ThatAquarel/Cheap-FOCer-2/source/Cheap FOCer 2 60mm.kicad_pcb

## KiCad design source/Cheap FOCer 2 60mm.kicad_pcb (2024-12-27)

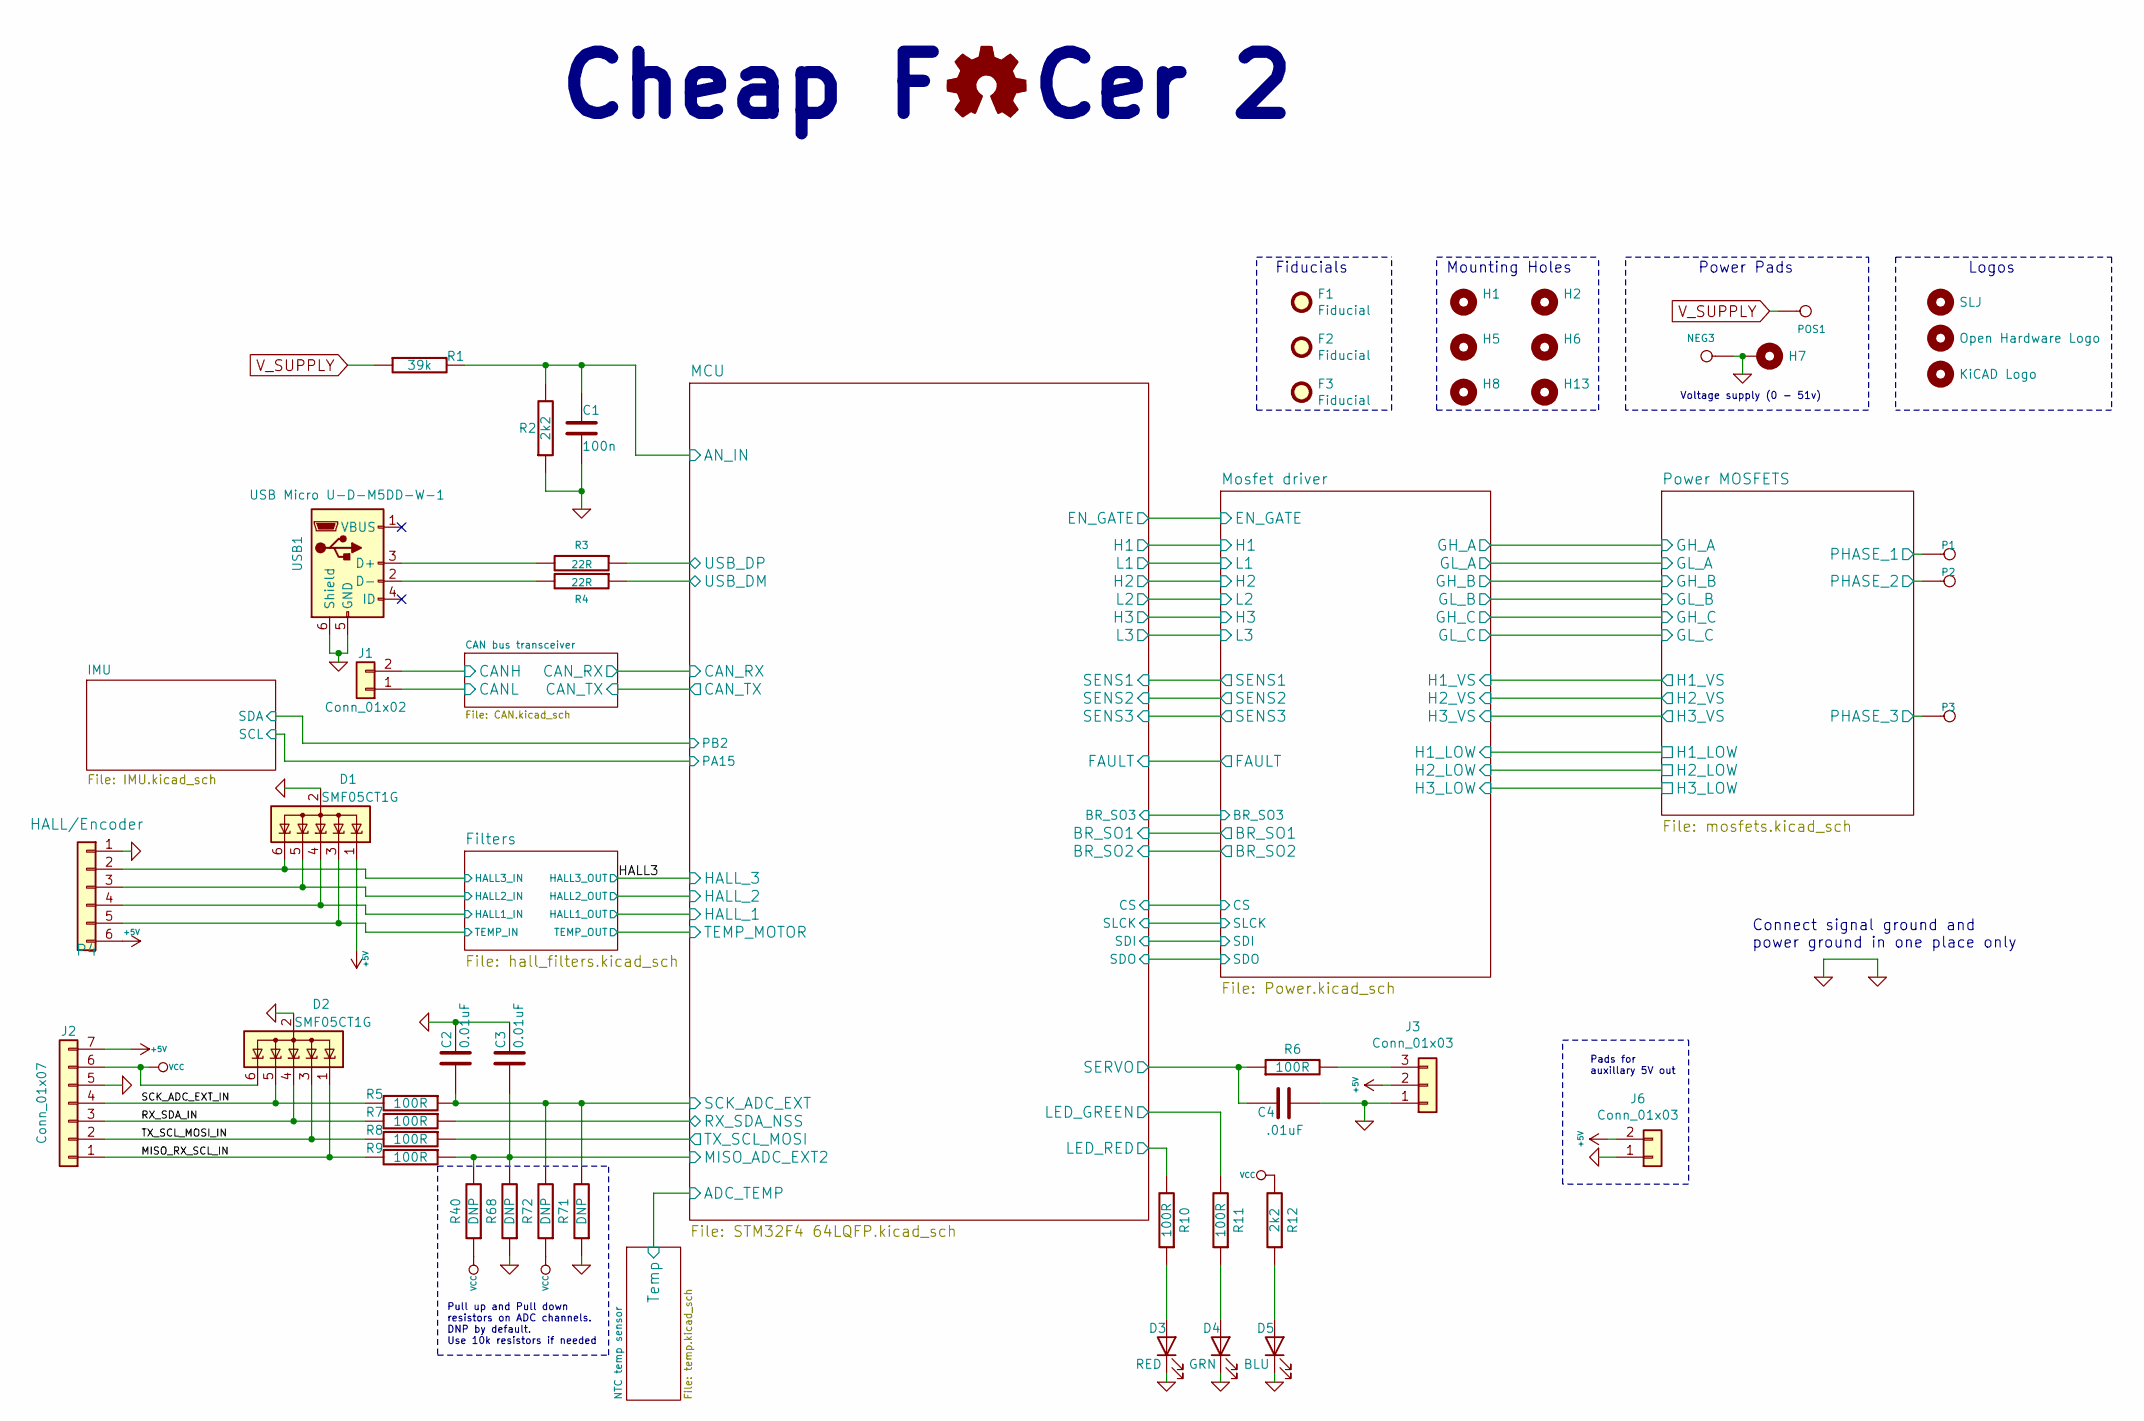
[picture p1: schematic Cheap FOCer 2 60mm.kicad_sch, Cheap FOCer 2]

Parts:
C1: 100n; C_0603_1608Metric
C2, C3: 0.01uF; C_0603_1608Metric
C4: .01uF; C_0603_1608Metric
D1, D2: SMF05CT1G; SOT-363_SC-70-6
D3: RED; LED_0603_1608Metric
D4: GRN; LED_0603_1608Metric
D5: BLU; LED_0603_1608Metric
F1, F2, F3: Fiducial; Fiducial_1mm_Dia_2mm_Outer
H1, H2, H5, H6, H7, H8, H13: MountingHole; MountingHole_3.2mm_M3_ISO14580_Pad
H3: SLJ; Sam_J
H4: Open Hardware Logo; OSHW-Logo2_9.8x8mm_SilkScreen
H9: KiCAD Logo; KiCad-Logo2_5mm_SilkScreen
J1: Conn_01x02; JST_PH_B2B-PH-K_1x02_P2.00mm_Vertical
J2: Conn_01x07; JST_PH_B7B-PH-K_1x07_P2.00mm_Vertical
J3: Conn_01x03; JST_PH_B3B-PH-K_1x03_P2.00mm_Vertical
J6: Conn_01x03; PinHeader_1x02_P2.54mm_Vertical
NEG3: MOTOR3; 1pin_4mm
P1, P2, P3: MOTOR1; 1pin_4mm
P4: HALL/Encoder; JST_PH_B6B-PH-K_1x06_P2.00mm_Vertical
POS1: POS; 1pin_4mm
R1: 39k; R_0603_1608Metric
R2, R12: 2k2; R_0603_1608Metric
R3, R4: 22R; R_0603_1608Metric
R5, R6, R7, R8, R9, R10, R11: 100R; R_0603_1608Metric
R40, R68, R71, R72: DNP; R_0603_1608Metric
USB1: USB Micro U-D-M5DD-W-1; USB_Micro-B_Wuerth_614105150721_Vertical

Connections:
+5V: D1.1 (K), J2.7, J3.2, J6.2, P4.6; also elsewhere on the board
/CAN bus transceiver/CANH: J1.2; also elsewhere on the board
/CAN bus transceiver/CANL: J1.1; also elsewhere on the board
/Filters/HALL1_IN: D1.4 (K), P4.4; also elsewhere on the board
/Filters/HALL2_IN: D1.5 (K), P4.3; also elsewhere on the board
/Filters/TEMP_IN: D1.3 (K), P4.5; also elsewhere on the board
/HALL3: D1.6 (K), P4.2; also elsewhere on the board
/MCU/AN_IN: C1.2, R1.2, R2.2; also elsewhere on the board
/MCU/LED_GREEN: R11.2; also elsewhere on the board
/MCU/LED_RED: R10.2; also elsewhere on the board
/MCU/MISO_ADC_EXT2: C3.2, R9.1, R40.2, R68.2; also elsewhere on the board
/MCU/RX_SDA_NSS: R7.1; also elsewhere on the board
/MCU/SCK_ADC_EXT: C2.2, R5.1, R71.2, R72.2; also elsewhere on the board
/MCU/SERVO: C4.2, R6.1; also elsewhere on the board
/MCU/TX_SCL_MOSI: R8.1; also elsewhere on the board
/MCU/USB_DM: R4.1; also elsewhere on the board
/MCU/USB_DP: R3.1; also elsewhere on the board
/MISO_RX_SCL_IN: D2.1 (K), J2.1, R9.2
/Mosfet driver/H1_VS: P1.1; also elsewhere on the board
/Mosfet driver/H2_VS: P2.1; also elsewhere on the board
/Mosfet driver/H3_VS: P3.1; also elsewhere on the board
/RX_SDA_IN: D2.4 (K), J2.3, R7.2
/SCK_ADC_EXT_IN: D2.5 (K), J2.4, R5.2
/TX_SCL_MOSI_IN: D2.3 (K), J2.2, R8.2
GND: C1.1, C2.1, C3.1, C4.1, D1.2 (A), D2.2 (A), D3.1 (K), D4.1 (K), D5.1 (K), H7.1, J2.5, J3.1, J6.1, NEG3.1, P4.1, R2.1, R68.1, R71.1, USB1.5 (GND), USB1.6 (Shield); also elsewhere on the board
unnamed: D3.2 (A), R10.1
unnamed: D4.2 (A), R11.1
unnamed: D5.2 (A), R12.1
unnamed: J3.3, R6.2
unnamed: R3.2, USB1.3 (D+)
unnamed: R4.2, USB1.2 (D-)
V_SUPPLY: POS1.1, R1.1; also elsewhere on the board

Notes on the sheet:
Mounting Holes
Pull up and Pull down resistors on ADC channels. DNP by default. Use 10k resistors if needed
Power Pads
Connect signal ground and power ground in one place only
Pads for auxillary 5V out
Logos
Fiducials
Voltage supply (0 - 51v)
Cheap F Cer 2

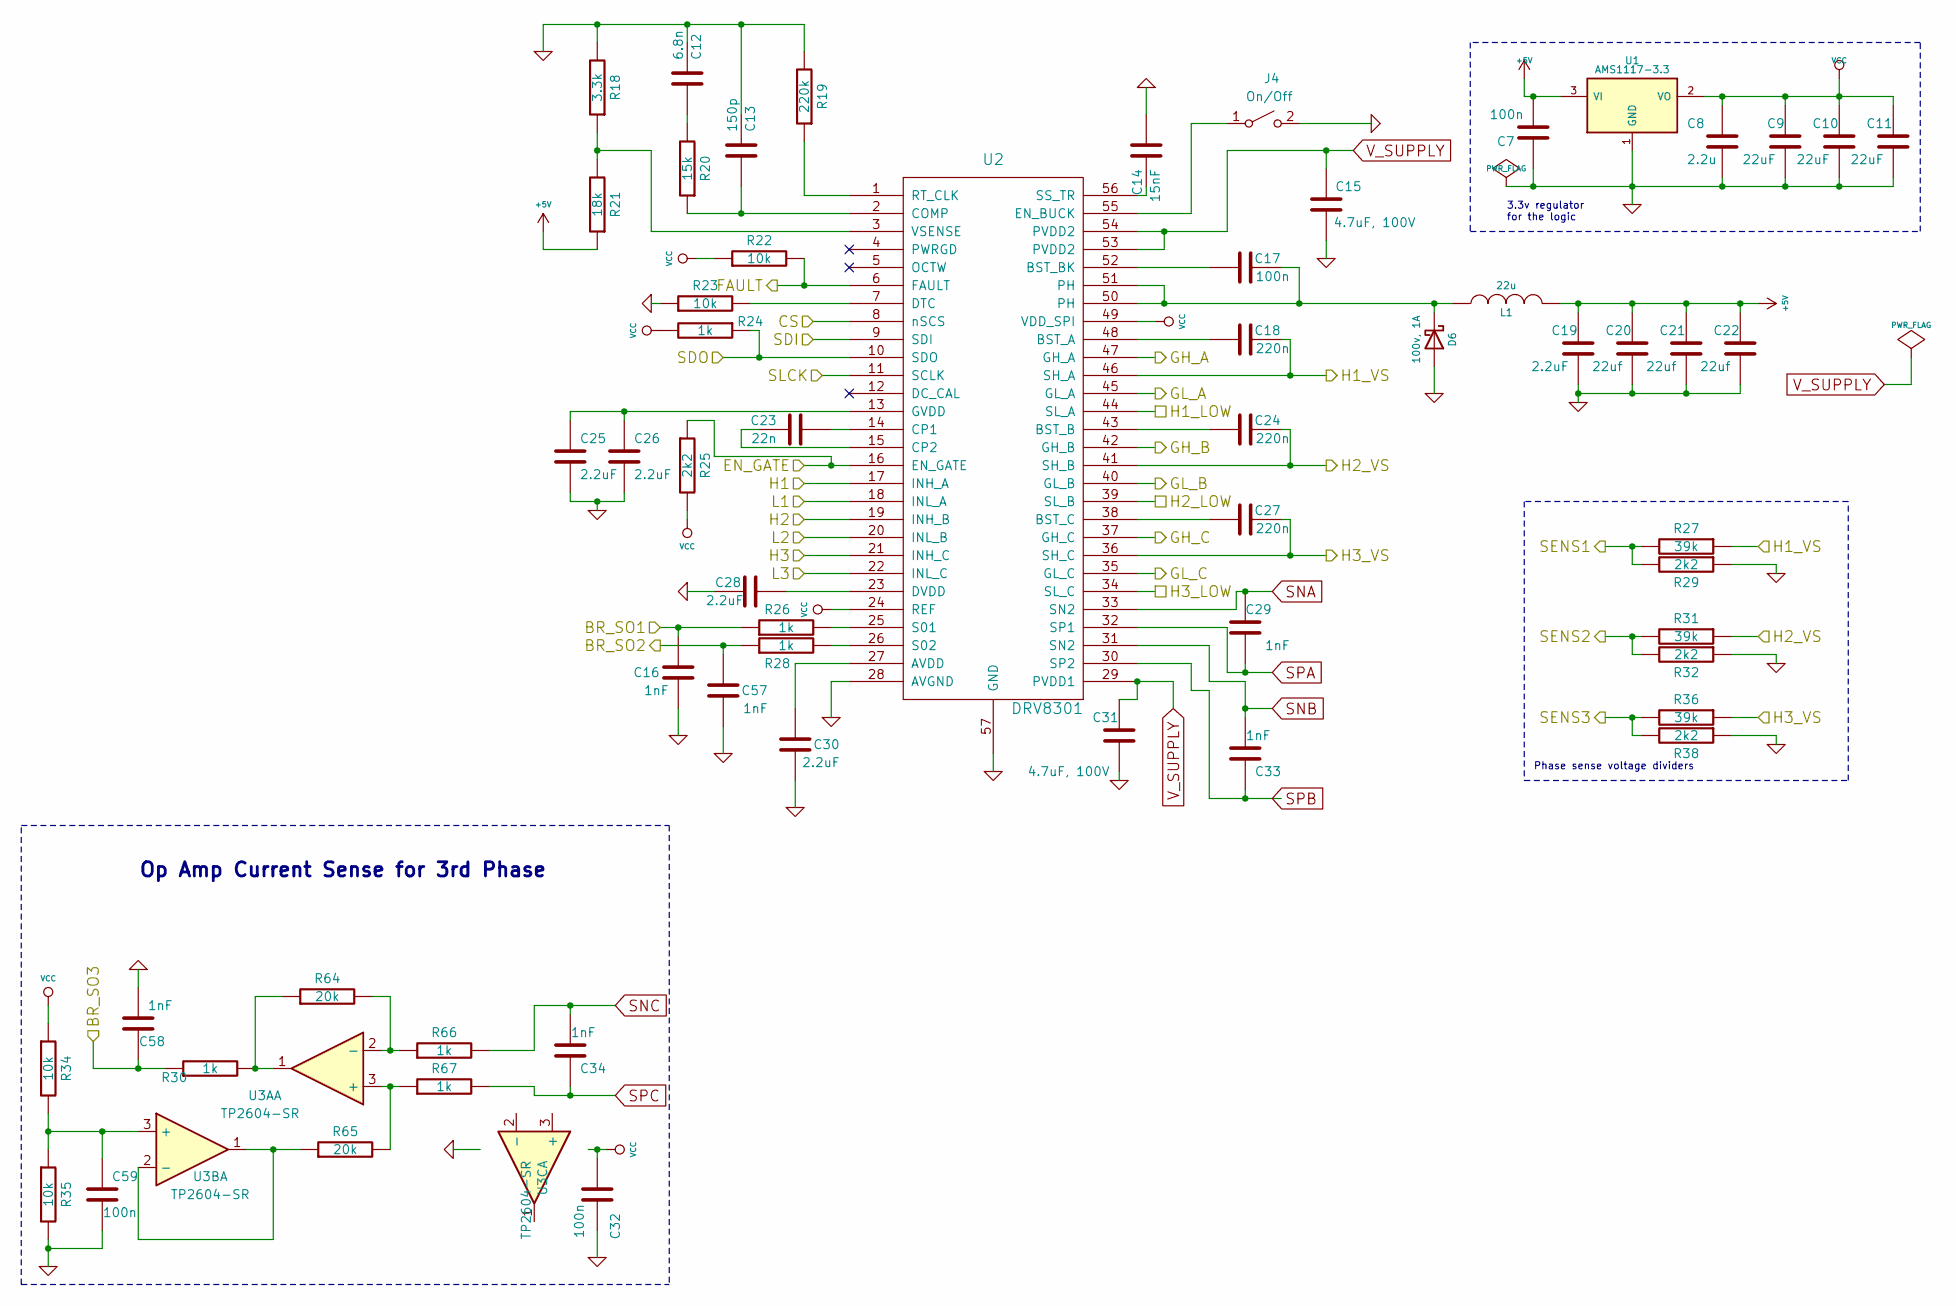
[picture p2: schematic Power.kicad_sch, Cheap FOCer 2]

Parts:
C7, C17, C32, C59: 100n; C_0603_1608Metric
C8: 2.2u; C_0603_1608Metric
C9, C10, C11: 22uF; C_0805_2012Metric
C12: 6.8n; C_0603_1608Metric
C13: 150p; C_0603_1608Metric
C14: 15nF; C_0603_1608Metric
C15, C31: 4.7uF, 100V; C_1210_3225Metric
C16, C29, C33, C34, C57, C58: 1nF; C_0603_1608Metric
C18, C24, C27: 220n; C_0603_1608Metric
C19, C25, C26, C28, C30: 2.2uF; C_0603_1608Metric
C20, C21, C22: 22uf; C_0805_2012Metric
C23: 22n; C_0603_1608Metric
D6: 100v, 1A; D_SMA
J4: On/Off; JST_PH_B2B-PH-K_1x02_P2.00mm_Vertical
L1: 22u; L_Taiyo-Yuden_NR-60xx_HandSoldering
R18: 3.3k; R_0603_1608Metric
R19: 220k; R_0603_1608Metric
R20: 15k; R_0603_1608Metric
R21: 18k; R_0603_1608Metric
R22, R23, R34, R35: 10k; R_0603_1608Metric
R24, R26, R28, R30, R66, R67: 1k; R_0603_1608Metric
R25, R29, R32, R38: 2k2; R_0603_1608Metric
R27, R31, R36: 39k; R_0603_1608Metric
R64, R65: 20k; R_0603_1608Metric
U1: AMS1117-3.3; SOT-223-3_TabPin2
U2: DRV8301; HTSSOP-56-1EP_6.1x14mm_P0.5mm_EP3.61x6.35mm
U3A, U3B, U3C: TP2604-SR; SOIC-8_3.9x4.9mm_P1.27mm

Connections:
+5V: C7.2, C19.2, C20.2, C21.2, C22.2, L1.2, R21.1, U1.3 (VI); also elsewhere on the board
/MCU/BR_SO1: C16.2, R26.1; also elsewhere on the board
/MCU/BR_SO2: C57.2, R28.1; also elsewhere on the board
/MCU/BR_SO3: C58.2, R30.1; also elsewhere on the board
/MCU/CS: U2.8 (nSCS); also elsewhere on the board
/MCU/EN_GATE: R25.1, U2.16 (EN_GATE); also elsewhere on the board
/MCU/FAULT: R22.2, U2.6 (FAULT); also elsewhere on the board
/MCU/H1: U2.17 (INH_A); also elsewhere on the board
/MCU/H2: U2.19 (INH_B); also elsewhere on the board
/MCU/H3: U2.21 (INH_C); also elsewhere on the board
/MCU/L1: U2.18 (INL_A); also elsewhere on the board
/MCU/L2: U2.20 (INL_B); also elsewhere on the board
/MCU/L3: U2.22 (INL_C); also elsewhere on the board
/MCU/SDI: U2.9 (SDI); also elsewhere on the board
/MCU/SDO: R24.1, U2.10 (SDO); also elsewhere on the board
/MCU/SENS1: R27.2, R29.2; also elsewhere on the board
/MCU/SENS2: R31.2, R32.2; also elsewhere on the board
/MCU/SENS3: R36.2, R38.2; also elsewhere on the board
/MCU/SLCK: U2.11 (SCLK); also elsewhere on the board
/Mosfet driver/GH_A: U2.47 (GH_A); also elsewhere on the board
/Mosfet driver/GH_B: U2.42 (GH_B); also elsewhere on the board
/Mosfet driver/GH_C: U2.37 (GH_C); also elsewhere on the board
/Mosfet driver/GL_A: U2.45 (GL_A); also elsewhere on the board
/Mosfet driver/GL_B: U2.40 (GL_B); also elsewhere on the board
/Mosfet driver/H1_VS: C18.2, R27.1, U2.46 (SH_A); also elsewhere on the board
/Mosfet driver/H2_LOW: U2.39 (SL_B); also elsewhere on the board
/Mosfet driver/H2_VS: C24.2, R31.1, U2.41 (SH_B); also elsewhere on the board
/Mosfet driver/H3_LOW: U2.34 (SL_C); also elsewhere on the board
/Mosfet driver/H3_VS: C27.2, R36.1, U2.36 (SH_C); also elsewhere on the board
GND: C7.1, C8.2, C9.1, C10.1, C11.1, C12.1, C13.1, C14.2, C15.1, C16.1, C19.1, C20.1, C21.1, C22.1, C25.2, C26.2, C28.2, C30.1, C31.1, C32.1, C57.1, C58.1, C59.2, D6.2 (A), J4.2 (B), R18.2, R19.2, R23.1, R29.1, R32.1, R35.2, R38.1, U1.1 (GND), U2.28 (AVGND), U2.57 (GND); also elsewhere on the board
unnamed: C12.2, R20.2
unnamed: C13.2, R20.1, U2.2 (COMP)
unnamed: C14.1, U2.56 (SS_TR)
unnamed: C17.1, U2.52 (BST_BK)
unnamed: C17.2, D6.1 (K), L1.1, U2.50 (PH), U2.51 (PH)
unnamed: C18.1, U2.48 (BST_A)
unnamed: C23.1, U2.15 (CP2)
unnamed: C23.2, U2.14 (CP1)
unnamed: C24.1, U2.43 (BST_B)
unnamed: C25.1, C26.1, U2.13 (GVDD)
unnamed: C27.1, U2.38 (BST_C)
unnamed: C28.1, U2.23 (DVDD)
unnamed: C30.2, U2.27 (AVDD)
unnamed 75: C59.1, R34.2, R35.1, U3B.3 (+); also elsewhere on the board
unnamed: J4.1 (A), U2.55 (EN_BUCK)
unnamed: R18.1, R21.2, U2.3 (VSENSE)
unnamed: R19.1, U2.1 (RT_CLK)
unnamed: R23.2, U2.7 (DTC)
unnamed: R26.2, U2.25 (S01)
unnamed: R28.2, U2.26 (S02)
unnamed 92: R30.2, R64.1, U3A.1; also elsewhere on the board
unnamed 93: R64.2, R66.1, U3A.2 (-); also elsewhere on the board
unnamed 94: R65.1, U3B.1, U3B.2 (-); also elsewhere on the board
unnamed 95: R65.2, R67.1, U3A.3 (+); also elsewhere on the board
SNA: C29.2, U2.33 (SN2); also elsewhere on the board
SNB: C33.1, U2.31 (SN2); also elsewhere on the board
SNC: C34.1, R66.2; also elsewhere on the board
SPA: C29.1, U2.32 (SP1); also elsewhere on the board
SPB: C33.2, U2.30 (SP2); also elsewhere on the board
SPC: C34.2, R67.2; also elsewhere on the board
V_SUPPLY: C15.2, C31.2, U2.29 (PVDD1), U2.53 (PVDD2), U2.54 (PVDD2); also elsewhere on the board

Notes on the sheet:
Phase sense voltage dividers
3.3v regulator for the logic
Op Amp Current Sense for 3rd Phase

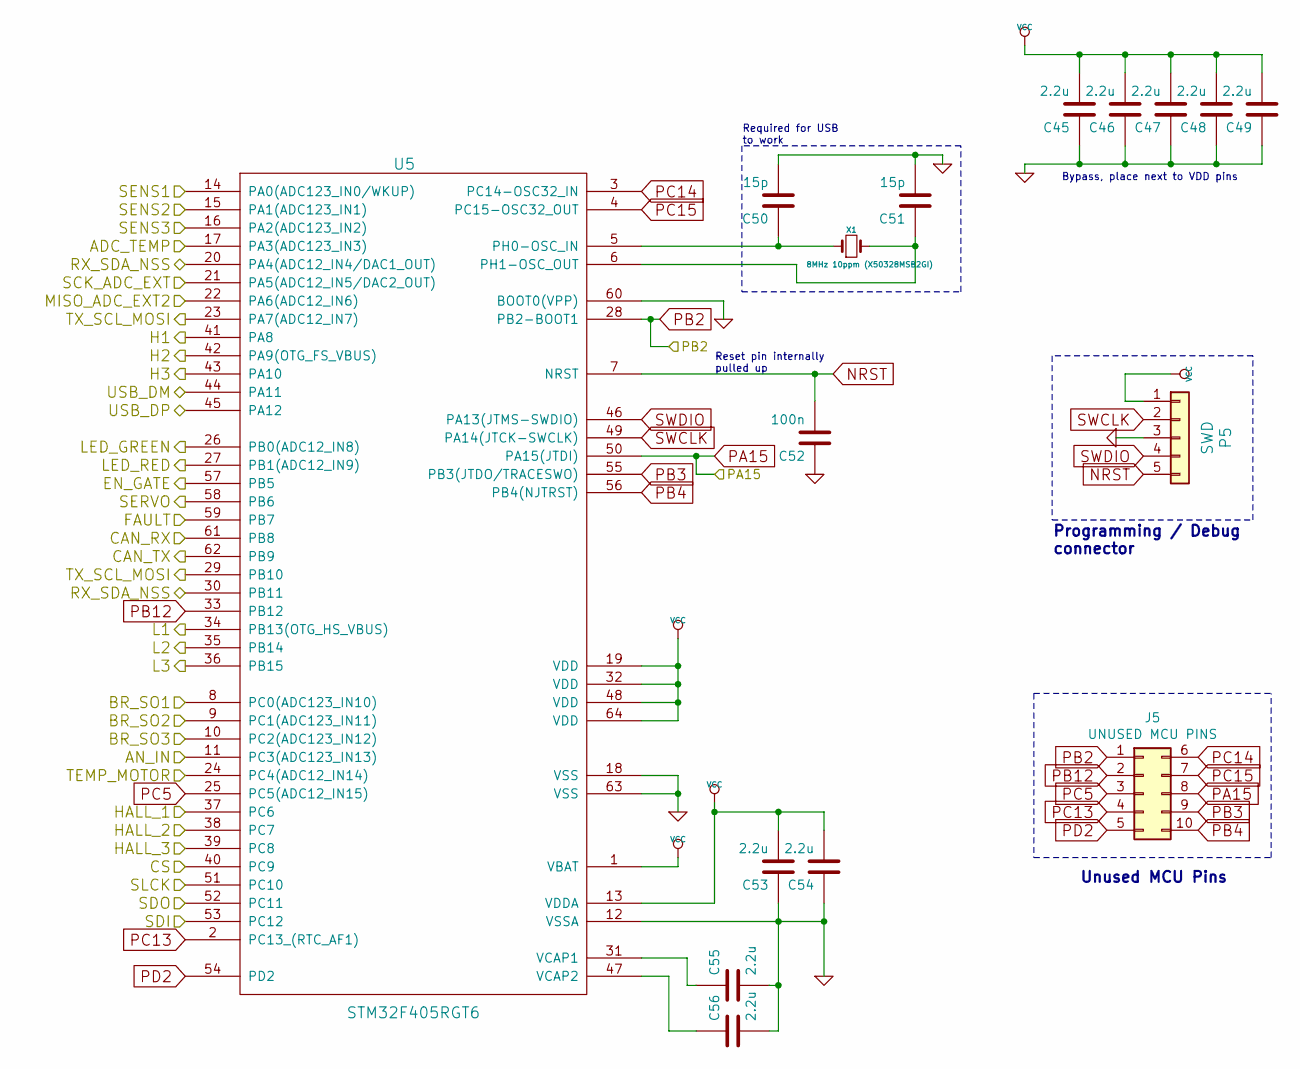
[picture p3: schematic STM32F4 64LQFP.kicad_sch, Cheap FOCer 2]

Parts:
C45, C46, C47, C48, C49, C53, C54, C55, C56: 2.2u; C_0603_1608Metric
C50, C51: 15p; C_0603_1608Metric
C52: 100n; C_0603_1608Metric
J5: UNUSED MCU PINS; PinHeader_2x05_P2.00mm_Vertical
P5: SWD; PinHeader_1x05_P2.54mm_Vertical
U5: STM32F405RGT6; LQFP-64_10x10mm_P0.5mm
X1: 8MHz 10ppm (X50328MSB2GI); Crystal_SMD_5032-2Pin_5.0x3.2mm; mfg# ABM3B-8.0-10-1UT

Connections:
/CAN bus transceiver/CAN_RX: U5.61 (PB8); also elsewhere on the board
/CAN bus transceiver/CAN_TX: U5.62 (PB9); also elsewhere on the board
/Filters/HALL1_IN: U5.37 (PC6); also elsewhere on the board
/Filters/HALL2_IN: U5.38 (PC7); also elsewhere on the board
/Filters/TEMP_IN: U5.24 (PC4(ADC12_IN14)); also elsewhere on the board
/HALL3: U5.39 (PC8); also elsewhere on the board
/MCU/ADC_TEMP: U5.17 (PA3(ADC123_IN3)); also elsewhere on the board
/MCU/AN_IN: U5.11 (PC3(ADC123_IN13)); also elsewhere on the board
/MCU/BR_SO1: U5.8 (PC0(ADC123_IN10)); also elsewhere on the board
/MCU/BR_SO2: U5.9 (PC1(ADC123_IN11)); also elsewhere on the board
/MCU/BR_SO3: U5.10 (PC2(ADC123_IN12)); also elsewhere on the board
/MCU/CS: U5.40 (PC9); also elsewhere on the board
/MCU/EN_GATE: U5.57 (PB5); also elsewhere on the board
/MCU/FAULT: U5.59 (PB7); also elsewhere on the board
/MCU/H1: U5.41 (PA8); also elsewhere on the board
/MCU/H2: U5.42 (PA9(OTG_FS_VBUS)); also elsewhere on the board
/MCU/H3: U5.43 (PA10); also elsewhere on the board
/MCU/L1: U5.34 (PB13(OTG_HS_VBUS)); also elsewhere on the board
/MCU/L2: U5.35 (PB14); also elsewhere on the board
/MCU/L3: U5.36 (PB15); also elsewhere on the board
/MCU/LED_GREEN: U5.26 (PB0(ADC12_IN8)); also elsewhere on the board
/MCU/LED_RED: U5.27 (PB1(ADC12_IN9)); also elsewhere on the board
/MCU/MISO_ADC_EXT2: U5.22 (PA6(ADC12_IN6)); also elsewhere on the board
/MCU/RX_SDA_NSS: U5.20 (PA4(ADC12_IN4/DAC1_OUT)), U5.30 (PB11); also elsewhere on the board
/MCU/SCK_ADC_EXT: U5.21 (PA5(ADC12_IN5/DAC2_OUT)); also elsewhere on the board
/MCU/SDI: U5.53 (PC12); also elsewhere on the board
/MCU/SDO: U5.52 (PC11); also elsewhere on the board
/MCU/SENS1: U5.14 (PA0(ADC123_IN0/WKUP)); also elsewhere on the board
/MCU/SENS2: U5.15 (PA1(ADC123_IN1)); also elsewhere on the board
/MCU/SENS3: U5.16 (PA2(ADC123_IN2)); also elsewhere on the board
/MCU/SERVO: U5.58 (PB6); also elsewhere on the board
/MCU/SLCK: U5.51 (PC10); also elsewhere on the board
/MCU/TX_SCL_MOSI: U5.23 (PA7(ADC12_IN7)), U5.29 (PB10); also elsewhere on the board
/MCU/USB_DM: U5.44 (PA11); also elsewhere on the board
/MCU/USB_DP: U5.45 (PA12); also elsewhere on the board
GND: C45.1, C46.1, C47.1, C48.1, C49.1, C50.2, C51.2, C52.1, C53.1, C54.1, C55.2, C56.2, P5.3, U5.12 (VSSA), U5.18 (VSS), U5.60 (BOOT0(VPP)), U5.63 (VSS); also elsewhere on the board
NRST: C52.2, P5.5, U5.7 (NRST)
unnamed: C50.1, U5.5 (PH0-OSC_IN), X1.1
unnamed: C51.1, U5.6 (PH1-OSC_OUT), X1.2
unnamed: C55.1, U5.31 (VCAP1)
unnamed: C56.1, U5.47 (VCAP2)
PB3: J5.9, U5.55 (PB3(JTDO/TRACESWO))
PB4: J5.10, U5.56 (PB4(NJTRST))
PB12: J5.2, U5.33 (PB12)
PC5: J5.3, U5.25 (PC5(ADC12_IN15))
PC13: J5.4, U5.2 (PC13_(RTC_AF1))
PC14: J5.6, U5.3 (PC14-OSC32_IN)
PC15: J5.7, U5.4 (PC15-OSC32_OUT)
PD2: J5.5, U5.54 (PD2)
SWCLK: P5.2, U5.49 (PA14(JTCK-SWCLK))
SWDIO: P5.4, U5.46 (PA13(JTMS-SWDIO))

Notes on the sheet:
Bypass, place next to VDD pins
Programming / Debug connector
Reset pin internally pulled up
Unused MCU Pins
Required for USB to work

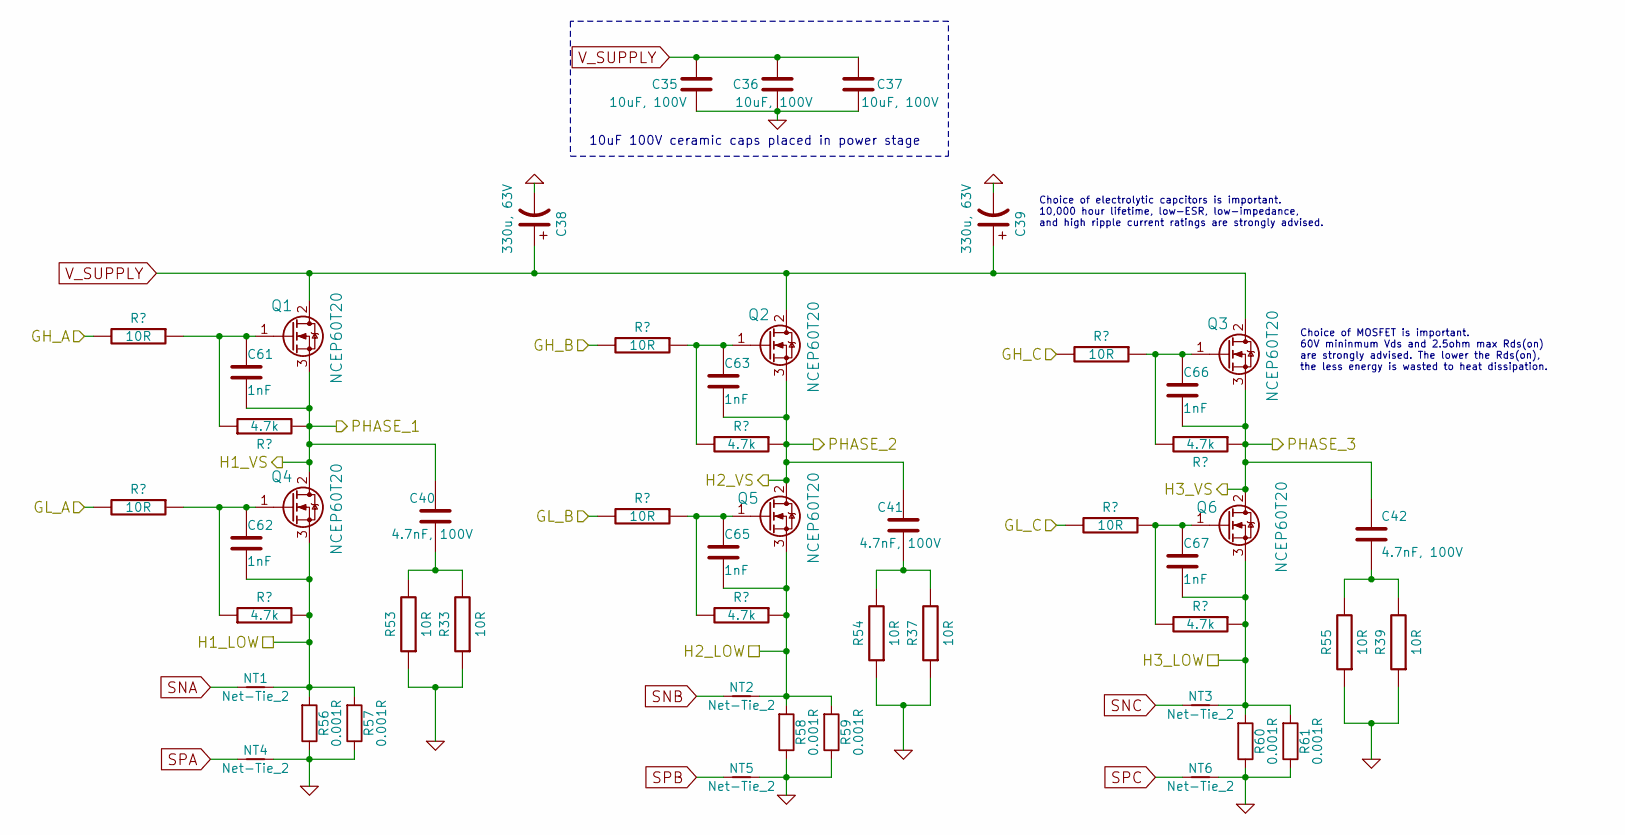
[picture p4: schematic mosfets.kicad_sch, Cheap FOCer 2]

Parts:
C35, C36, C37: 10uF, 100V; C_2220_5650Metric_Pad1.97x5.40mm_HandSolder
C38, C39: 330u, 63V; CP_10x20mm_hor_with_model_brd_edge
C40, C41, C42: 4.7nF, 100V; C_0805_2012Metric
C61, C62, C63, C65, C66, C67: 1nF; C_0603_1608Metric
NT1, NT2, NT3, NT4, NT5, NT6: Net-Tie_2; NetTie-2_SMD_Pad0.5mm
Q1, Q2, Q3, Q4, Q5, Q6: NCEP60T20; TO-220-3_Horizontal_TabUp_no_hole
R33, R37, R39, R41, R42, R43, R47, R48, R49, R53, R54, R55: 10R; R_0805_2012Metric
R44, R45, R46, R50, R51, R52: 4.7k; R_0603_1608Metric
R56, R57, R58, R59, R60, R61: 0.001R; R_2512_Yageo_big_pads

Connections:
/Mosfet driver/GH_A: R41.2; also elsewhere on the board
/Mosfet driver/GH_B: R42.2; also elsewhere on the board
/Mosfet driver/GH_C: R43.2; also elsewhere on the board
/Mosfet driver/GL_A: R47.2; also elsewhere on the board
/Mosfet driver/GL_B: R48.2; also elsewhere on the board
/Mosfet driver/H1_VS: C40.1, C61.2, Q1.3 (S), Q4.2 (D), R44.2; also elsewhere on the board
/Mosfet driver/H2_LOW: C65.2, NT2.2, Q5.3 (S), R51.1, R58.2, R59.2; also elsewhere on the board
/Mosfet driver/H2_VS: C41.1, C63.2, Q2.3 (S), Q5.2 (D), R45.1; also elsewhere on the board
/Mosfet driver/H3_LOW: C67.2, NT3.2, Q6.3 (S), R52.1, R60.2, R61.2; also elsewhere on the board
/Mosfet driver/H3_VS: C42.1, C66.2, Q3.3 (S), Q6.2 (D), R46.1; also elsewhere on the board
GND: C35.1, C36.1, C37.1, C38.2, C39.2, NT4.2, NT5.2, NT6.2, R33.1, R37.1, R39.1, R53.1, R54.1, R55.1, R56.1, R57.1, R58.1, R59.1, R60.1, R61.1; also elsewhere on the board
unnamed: C40.2, R33.2, R53.2
unnamed: C41.2, R37.2, R54.2
unnamed: C42.2, R39.2, R55.2
unnamed: C61.1, Q1.1 (G), R41.1, R44.1
unnamed: C63.1, Q2.1 (G), R42.1, R45.2
unnamed: C65.1, Q5.1 (G), R48.1, R51.2
unnamed: C66.1, Q3.1 (G), R43.1, R46.2
SNA: NT1.1; also elsewhere on the board
SNB: NT2.1; also elsewhere on the board
SNC: NT3.1; also elsewhere on the board
SPA: NT4.1; also elsewhere on the board
SPB: NT5.1; also elsewhere on the board
SPC: NT6.1; also elsewhere on the board
V_SUPPLY: C35.2, C36.2, C37.2, C38.1, C39.1, Q1.2 (D), Q2.2 (D), Q3.2 (D); also elsewhere on the board

Notes on the sheet:
10uF 100V ceramic caps placed in power stage
Choice of MOSFET is important. 60V mininmum Vds and 2.5ohm max Rds(on) are strongly advised. The lower the Rds(on), the less energy is wasted to heat dissipation.
Choice of electrolytic capcitors is important. 10,000 hour lifetime, low-ESR, low-impedance, and high ripple current ratings are strongly advised.

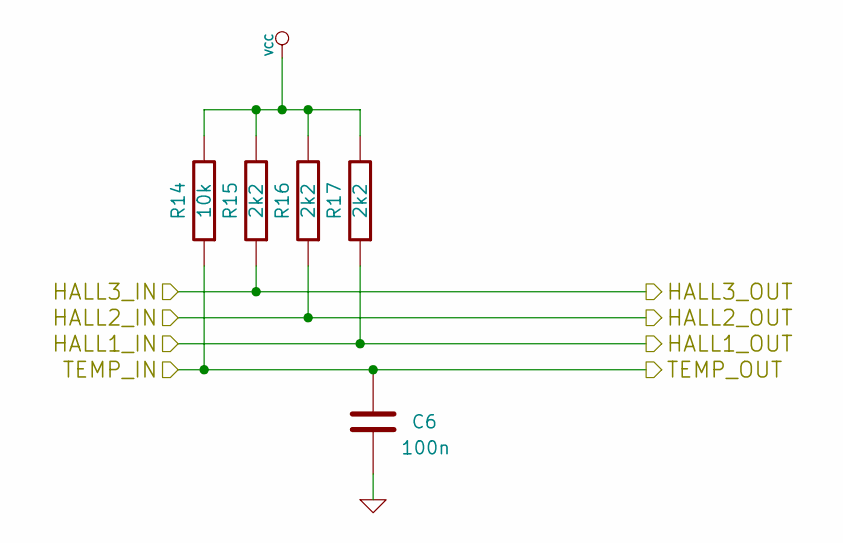
[picture p5: schematic hall_filters.kicad_sch, Cheap FOCer 2]

Parts:
C6: 100n; C_0603_1608Metric
R14: 10k; R_0603_1608Metric
R15, R16, R17: 2k2; R_0603_1608Metric

Connections:
/Filters/HALL1_IN: R17.1; also elsewhere on the board
/Filters/HALL2_IN: R16.1; also elsewhere on the board
/Filters/TEMP_IN: C6.2, R14.1; also elsewhere on the board
/HALL3: R15.1; also elsewhere on the board
GND: C6.1; also elsewhere on the board


Parts:
C5: 2.2u; C_0603_1608Metric
NTC1: NTC 10k; R_0603_1608Metric
R13: 10k; R_0603_1608Metric

Connections:
/MCU/ADC_TEMP: C5.1, NTC1.2, R13.1; also elsewhere on the board
GND: C5.2, R13.2; also elsewhere on the board

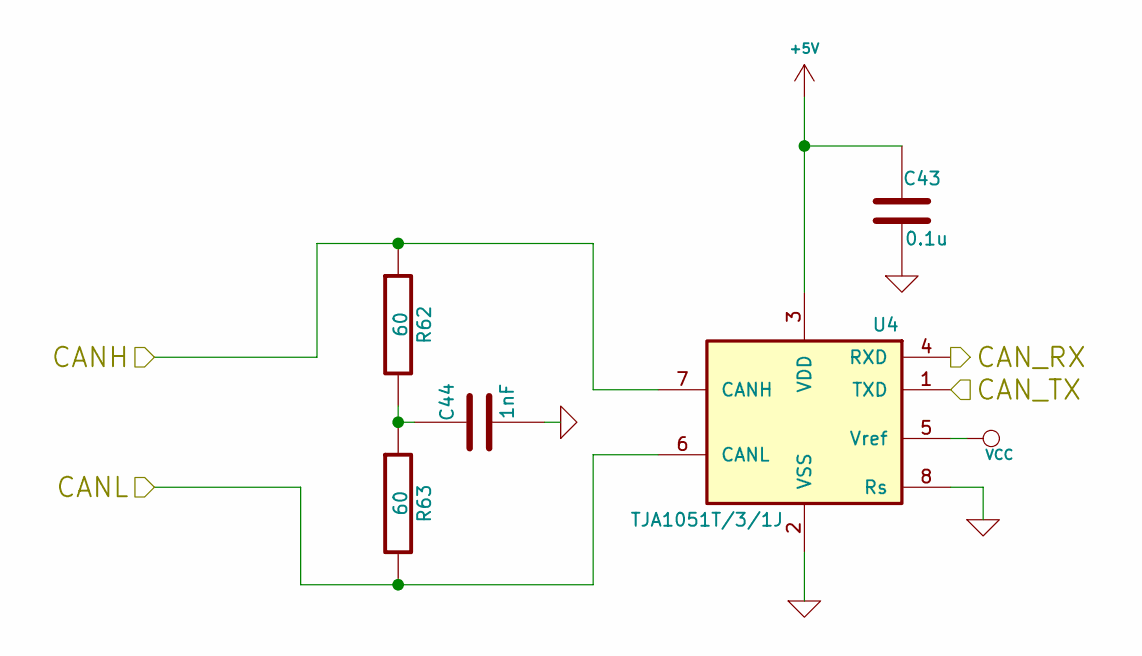
[picture p7: schematic CAN.kicad_sch, Cheap FOCer 2]

Parts:
C43: 0.1u; C_0603_1608Metric
C44: 1nF; C_0603_1608Metric
R62, R63: 60; R_0603_1608Metric
U4: TJA1051T/3/1J; SOIC-8_3.9x4.9mm_P1.27mm

Connections:
+5V: C43.1, U4.3 (VDD); also elsewhere on the board
/CAN bus transceiver/CANH: R62.1, U4.7 (CANH); also elsewhere on the board
/CAN bus transceiver/CANL: R63.2, U4.6 (CANL); also elsewhere on the board
/CAN bus transceiver/CAN_RX: U4.4 (RXD); also elsewhere on the board
/CAN bus transceiver/CAN_TX: U4.1 (TXD); also elsewhere on the board
GND: C43.2, C44.2, U4.2 (VSS), U4.8 (Rs); also elsewhere on the board
unnamed: C44.1, R62.2, R63.1

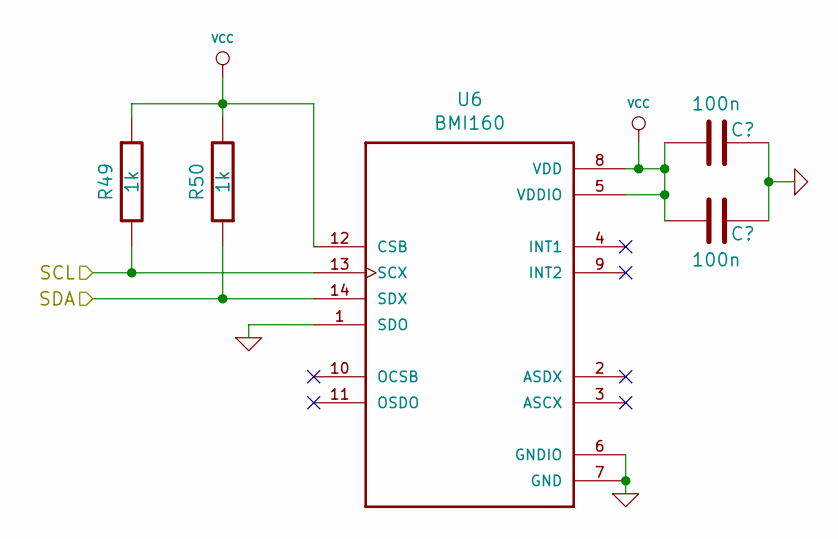
[picture p8: schematic IMU.kicad_sch, Cheap FOCer 2]

Parts:
C60, C64: 100n; C_0603_1608Metric
R49, R50: 1k; R_0603_1608Metric
U6: BMI160; Bosch_LGA-14_3x2.5mm_P0.5mm

Connections:
GND: C60.1, C64.1, U6.1 (SDO), U6.6 (GNDIO), U6.7 (GND); also elsewhere on the board

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
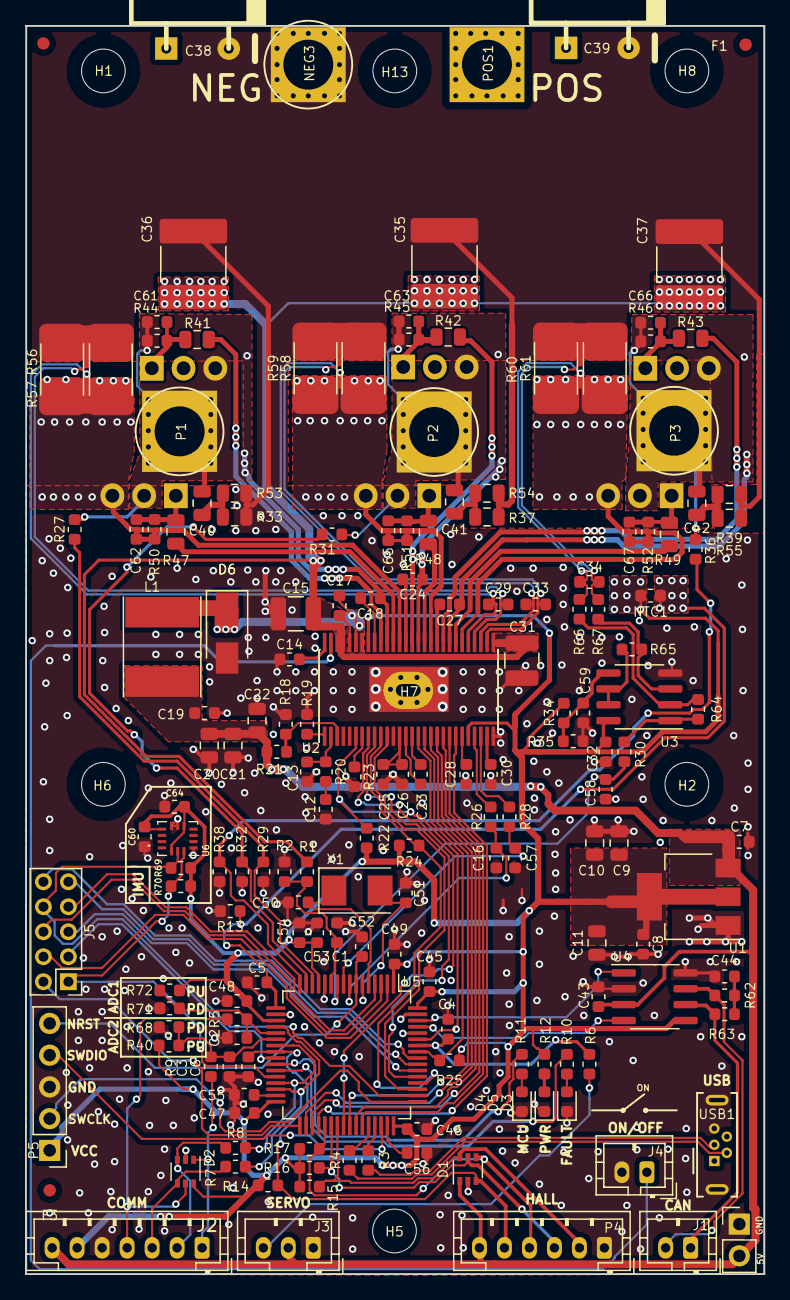
[picture p9: board Cheap FOCer 2 60mm.kicad_pcb from above]

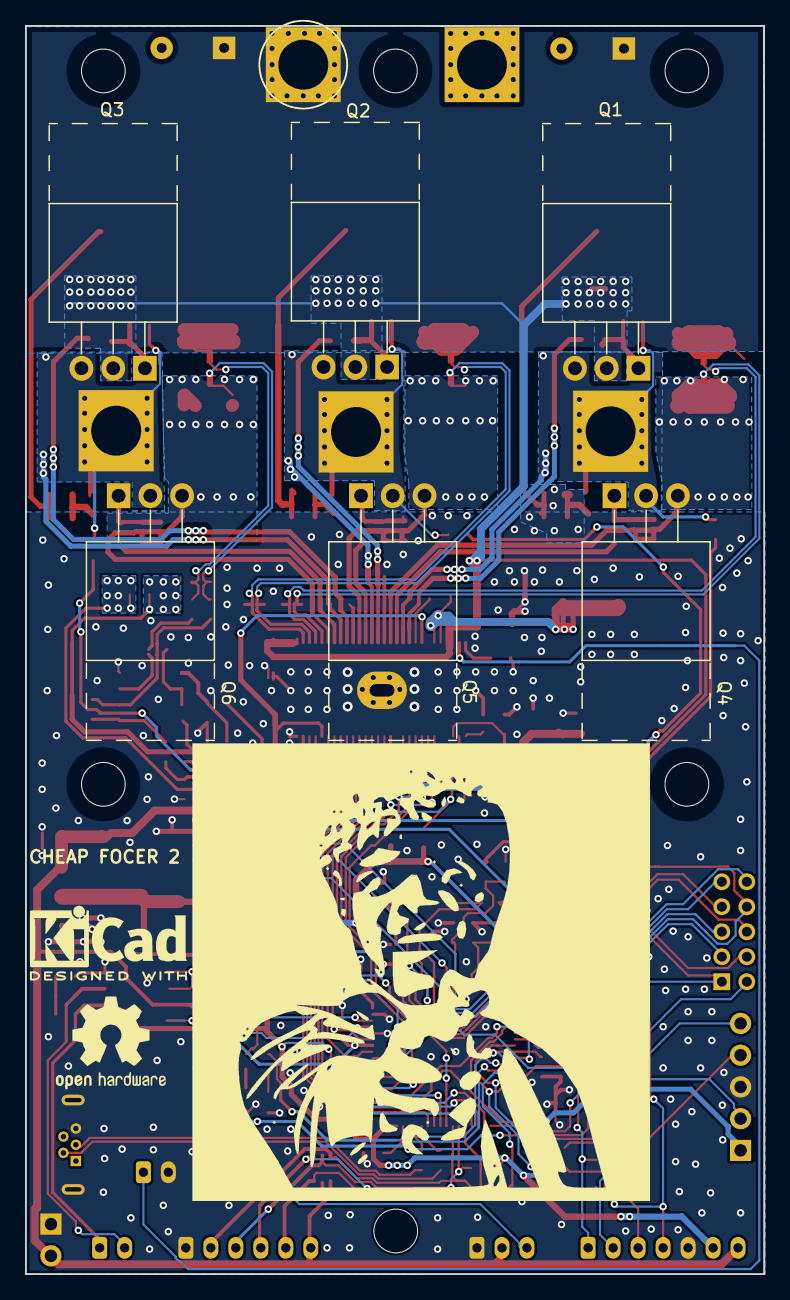
[picture p10: board Cheap FOCer 2 60mm.kicad_pcb from below]

Board: 2 copper layers, 59.1 x 99.9 mm, 193 parts (10 on the bottom side), 120 nets.

Other parts of the board:
R69, R70: 1k; R_0603_1608Metric
U3: TP2604-SR; SOIC-8_3.9x4.9mm_P1.27mm

Their connections:
GND: U3.4; also elsewhere on the board
unnamed 75: U3.5; also elsewhere on the board
unnamed 92: U3.1; also elsewhere on the board
unnamed 93: U3.2; also elsewhere on the board
unnamed 94: U3.6, U3.7; also elsewhere on the board
unnamed 95: U3.3; also elsewhere on the board
